adafruit/Adafruit-AP3429A-PCB/AP3429 3.3 Buck rev A.brd

## EAGLE design AP3429 3.3 Buck rev A.brd (2020-09-02)

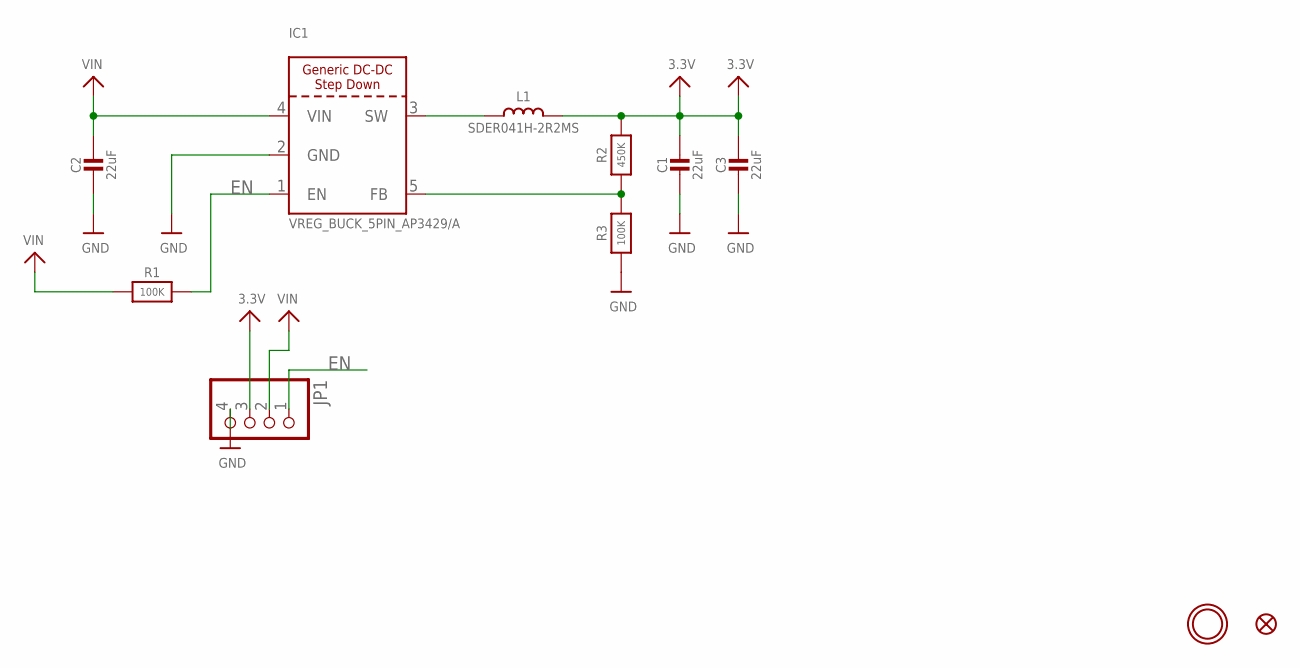
[picture p2: schematic AP3429 3.3 Buck rev A.sch]

Parts:
C1, C2, C3: 22uF; 0805-NO
FID1: FIDUCIAL_1MM
IC1: VREG_BUCK_5PIN_AP3429/A; SOT23-5
JP1: HEADER-1X4ROUND; 1X04_ROUND
L1: SDER041H-2R2MS; INDUCTOR_TAIYOYUDEN_NRH2412T
R1, R3: 100K; 0603-NO
R2: 450K; 0603-NO
U$9: MOUNTINGHOLE2.5; MOUNTINGHOLE_2.5_PLATED

Connections:
3.3V: C1.1, C3.1, JP1.3, L1.2, R2.2
EN: IC1.1 (EN), JP1.1, R1.2
FB: IC1.5 (FB), R2.1, R3.2
GND: C1.2, C2.2, C3.2, IC1.2 (GND), JP1.4, R3.1
unnamed: IC1.3 (SW), L1.1
VIN: C2.1, IC1.4 (VIN), JP1.2, R1.1

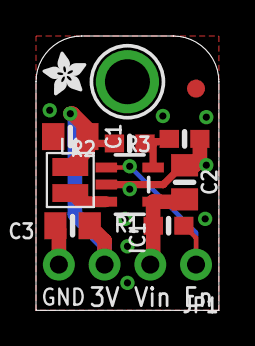
[picture p3: board AP3429 3.3 Buck rev A.brd from above]

Board: 2 copper layers, 10.2 x 15.2 mm, 13 parts (1 on the bottom side), 6 nets.

Other parts of the board:
U$10: PCBFEAT-REV-040
U$11: ADAFRUIT_2.5MM
